TinyChipHub/bitaxeHex-TCH/Manufacturing Files/bitaxeSupraHex-702-BOM-JLC-res.xlsx

Designator | Footprint | Comment
R18,R17,R49,R71,R26,R28,R75,R48,R62,R61,R52,R58,R43,R36,R74,R6,R57,R70,R35,R53,R44,R27 | R_0402_1005Metric | 10k
J1,J2 | 63862-1 | Conn_01x01
J8,J9 | 470531000 | Conn_01x04
C23 | C_0805_2012Metric | 100nF
R25,R24 | R_0402_1005Metric | 5.6k
SW2,SW1 | TL3340-switch | SWITCH-SPST
L2 | L_Coilcraft_XAL1010-XXX | 680nH
C13 | C_0402_1005Metric | 100nF
C5 | C_0603_1608Metric | 1uF
C10,C30 | CP_Elec_6.3x5.9 | 180uF
J6 | PinHeader_1x06_P2.54mm_Vertical | Conn_01x06
U12,U28,U25,U27 | BM1368 | BM1368_mode1
R8 | R_0402_1005Metric | 12.7K
C40,C38,C44,C39,C35,C43,C34 | C_0402_1005Metric | 311-3342-1-ND
C27,C28,C29 | C_1210_3225Metric | 47uF
C2 | C_0402_1005Metric | 4.7nF
U9 | MSOP-10_3x3mm_P0.5mm | EMC2302
R9,R16 | R_0402_1005Metric | 1.37K
R13 | R_0402_1005Metric | 10R
U3 | LQFN40-CLIP | TPS546D24ARVFR
C16,C155,C152,C156,C26,C157,C154,C153 | C_0402_1005Metric | 2.2nF
U7,U8 | SOT5X3-6_DRL_TEX | TMP1075
C22 | C_0805_2012Metric | 1nF
U18,U13 | BM1368 | BM1368_mode0
J5 | PinHeader_1x04_P2.54mm_Vertical | Conn_01x04
U6 | ESP32-S3-WROOM-1U | ESP32-S3-WROOM-1
C9,C8,C4,C7 | C_1210_3225Metric | 22uF
C32,C57,C113,C107,C129,C94,C72,C131,C70,C87,C92,C52,C59,C114,C144,C91,C150,C67,C76,C108,C88,C126,C66,C112,C19,C69,C97,C149,C124,C118,C138,C100,C63,C125,C133,C143,C116,C81,C83,C137,C96,C45,C109,C99,C145,C64,C55,C117,C48,C78,C102,C90,C110,C61,C146,C77,C127,C47,C54,C79,C135,C85,C58,C141,C105,C148,C25,C134,C56,C103,C46,C115,C104,C75,C53,C74,C89,C98,C123,C11,C139,C71,C128,C119,C80,C120,C49,C65,C86,C21,C136 | C_0402_1005Metric | 1uF
J7 | USB_C_Receptacle_GCT_USB4105-xx-A_16P_TopMnt_Horizontal | USB_C_Receptacle_USB2.0
R14 | R_1206_3216Metric | 1R
C24 | C_0402_1005Metric | 100pF
C14,C15 | C_0805_2012Metric | 1uF
C12,C50,C132,C147,C111,C84,C60,C142,C130,C106,C51,C122,C121,C62,C33,C93,C95,C151,C82,C73 | C_0402_1005Metric | 0.1uF
R20,R12 | R_0402_1005Metric | 22.1k
C18,C3,C20,C31,C1 | C_0805_2012Metric | 10uF
R47,R37,R73,R69,R54,R81,R59,R34,R51,R79,R78,R55,R72,R56,R83,R82,R80,R76,R77,R50,R42,R60,R67,R45 | R_0402_1005Metric | 1k
C140,C68,C101 | CP_EIA-7343-31_Kemet-D_Pad2.25x2.55mm_HandSolder | 330uF
U23,U11,U16,U24,U10,U17 | TSOT-23-5 | AP7331
R39,R11,R31,R41,R63,R29,R65 | R_0402_1005Metric | 115k
R64,R38,R30 | R_0402_1005Metric | 115k
U4 | SOT-23-5_HandSoldering | MIC5504-1.8YM5-TR
R4,R5 | R_0402_1005Metric | 17.8K
R68,R33,R46 | R_0402_1005Metric | 2k
U5 | TSSOP-16_4.4x5mm_P0.65mm | SN74AVC4T774
R15 | R_0402_1005Metric | 49.9R
R19 | R_0402_1005Metric | 7.87k
U20 | TSSOP-20 | MAX6689UP9A+
R66,R32,R40 | R_0402_1005Metric | 402k
R87,R86,R85,R84 | R_0402_1005Metric | 4.7k
U21,U15 | TSSOP-14_4.4x5mm_P0.65mm | TLV3544
U2 | RT9080-33GJ5 | RT9080-33GJ5
R3,R2,R1 | R_0402_1005Metric | 0R
R23,R22 | R_0402_1005Metric | 5.1k
C41,C42 | CP_Elec_6.3x7.7 | 220uF
C17 | C_0402_1005Metric | 4.7uF
U1 | SOT-23-6 | LMR54410
R7 | R_0402_1005Metric | 31.6K
U14,U19,U26 | O 25,0-JO32-B-1V3-1-T1-LF | 25MHz
R21 | R_0402_1005Metric | 20k
R10 | R_0402_1005Metric | 26.1K
L1 | 74438357082 | 8.2 uH
C6 | C_0603_1608Metric | 0.1uF
D1 | DFN1610-2L | 824045812
R88,R89,R90,R91,R92,R93,R94,R95,R96,R97,R98,R99 | R_0201 | C106229
