TinyChipHub/bitaxeHex-TCH/3d/Download_STP_WE-TVS-DFN1610-2L_rev1.stp

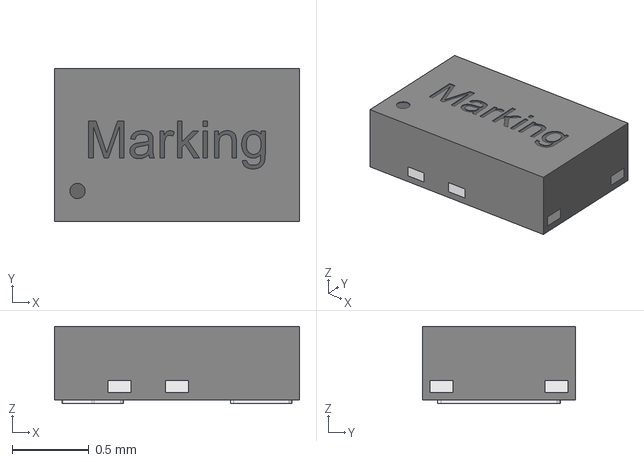
[picture p1: CAD file, 2024-09-07]
3d/Download_STP_WE-TVS-DFN1610-2L_rev1.stp
1.60 x 1.00 x 0.505 mm
pins x 7
housing
