TinyChipHub/bitaxeHex-TCH/3d/21-0066J_20_MXM.step

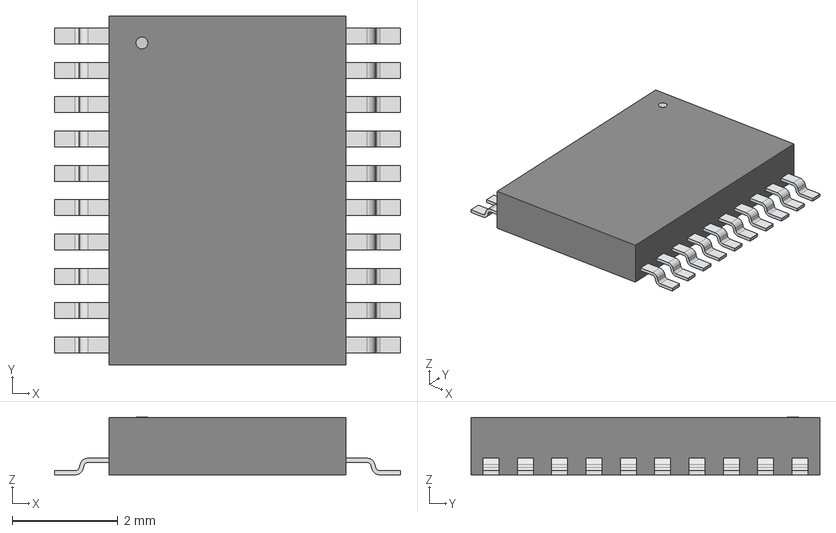
[picture p2: CAD file, 2024-08-14]
3d/21-0066J_20_MXM.step
6.55 x 6.60 x 1.09 mm
