TinyChipHub/bitaxeHex-TCH/3d/BM1368xx.stp

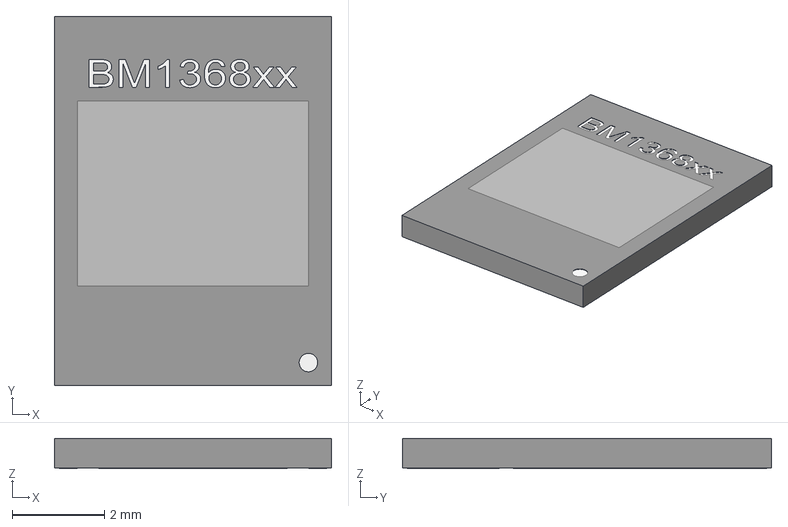
[picture p3: CAD file, 2024-08-13]
3d/BM1368xx.stp
6.00 x 8.00 x 0.65 mm
