TinyChipHub/bitaxeHex-TCH/bitaxeHex.pdf

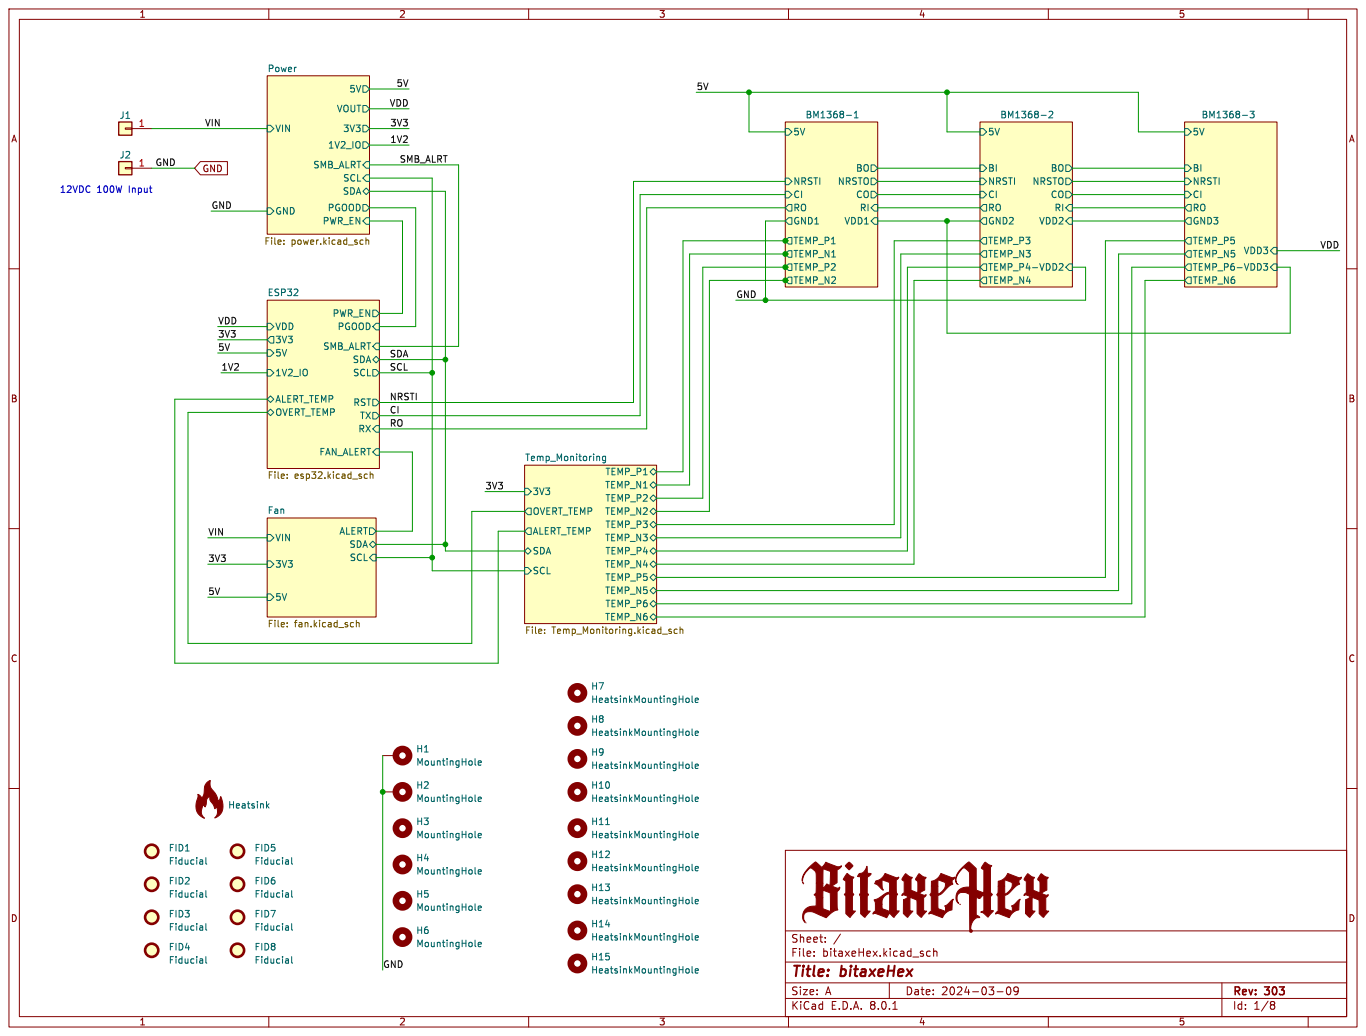
[picture p4: page 1]

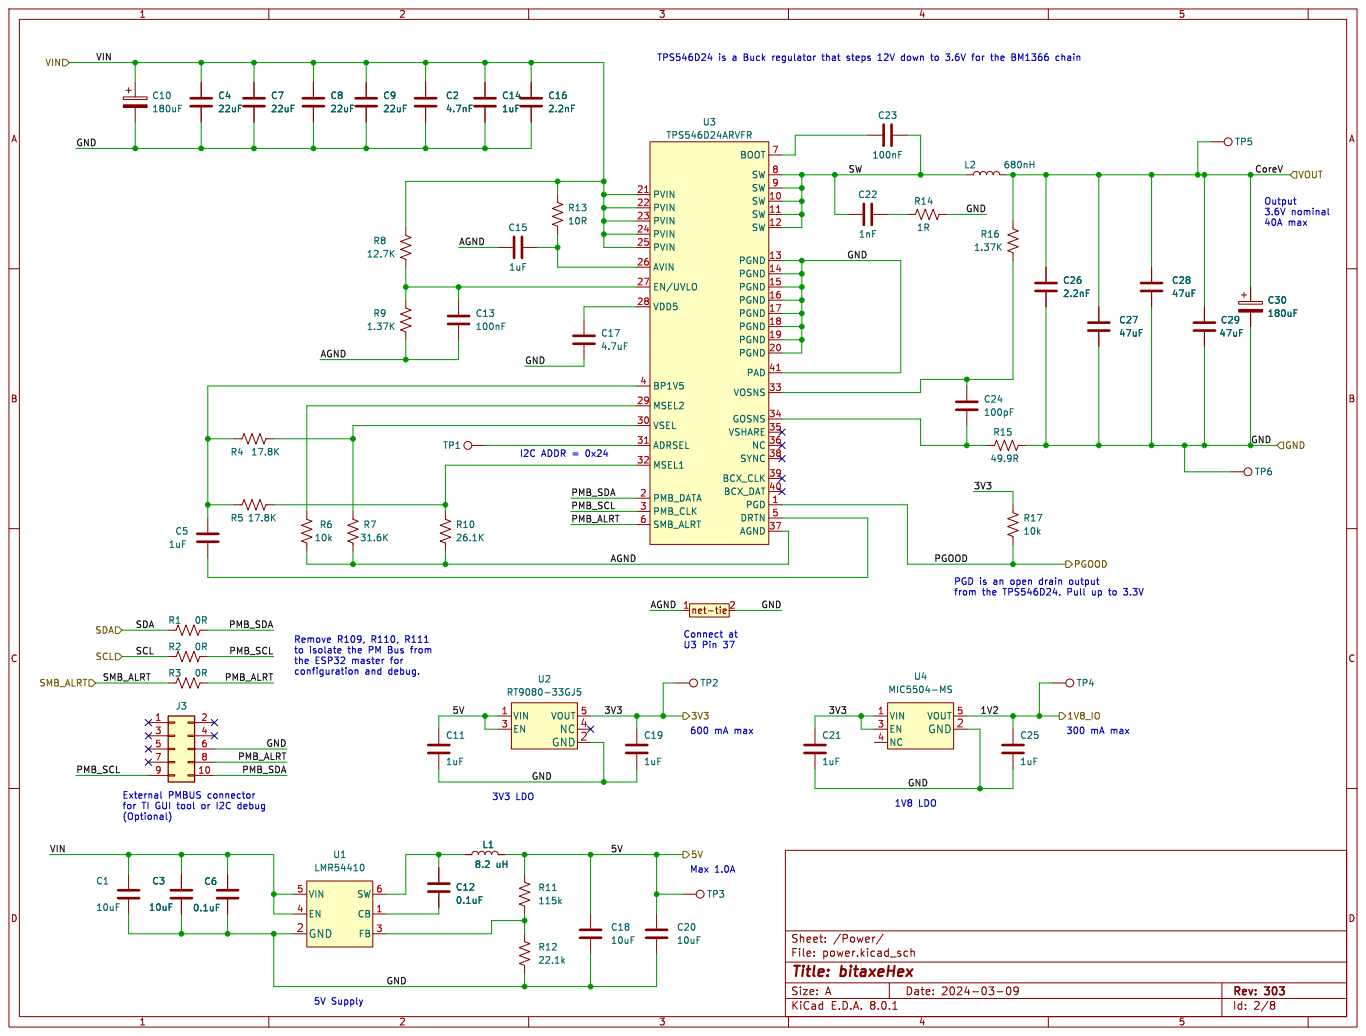
[picture p5: page 2]

File: power.kicad_sch Sheet: /Power/ C5

300 mA max PGD is an open drain output

Remove R109, R110, R111
to isolate the PM Bus from

for TI GUI tool or I2C debug
(Optional)

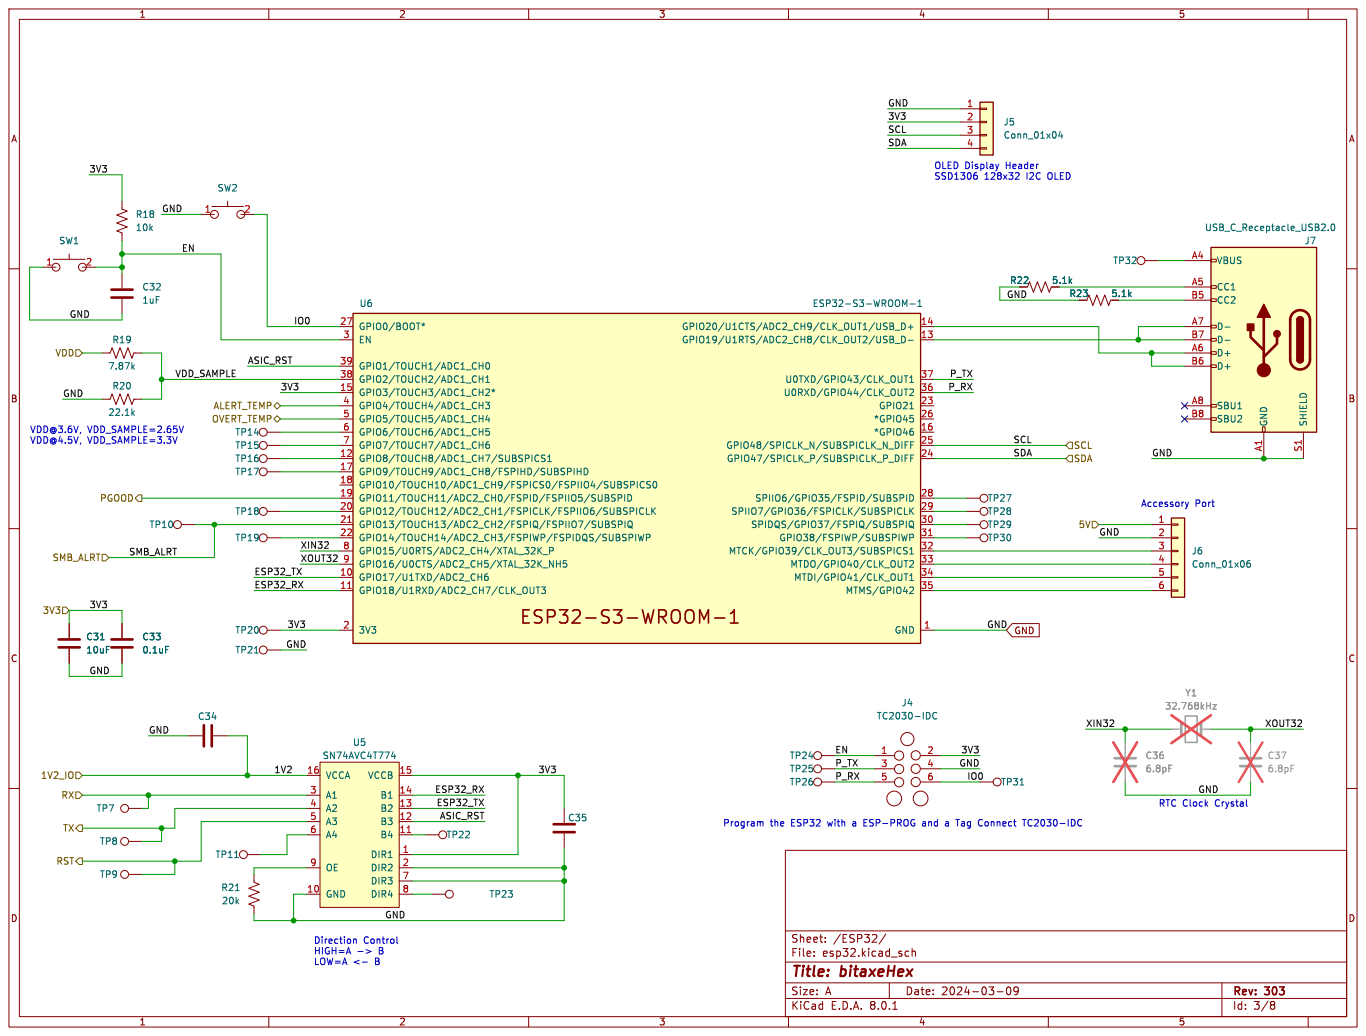
[picture p6: page 3]

Accessory Port OLED Display Header SSD1306 128x32 I2C OLED

Program the ESP32 with a ESP-PROG and a Tag Connect TC2030-IDC

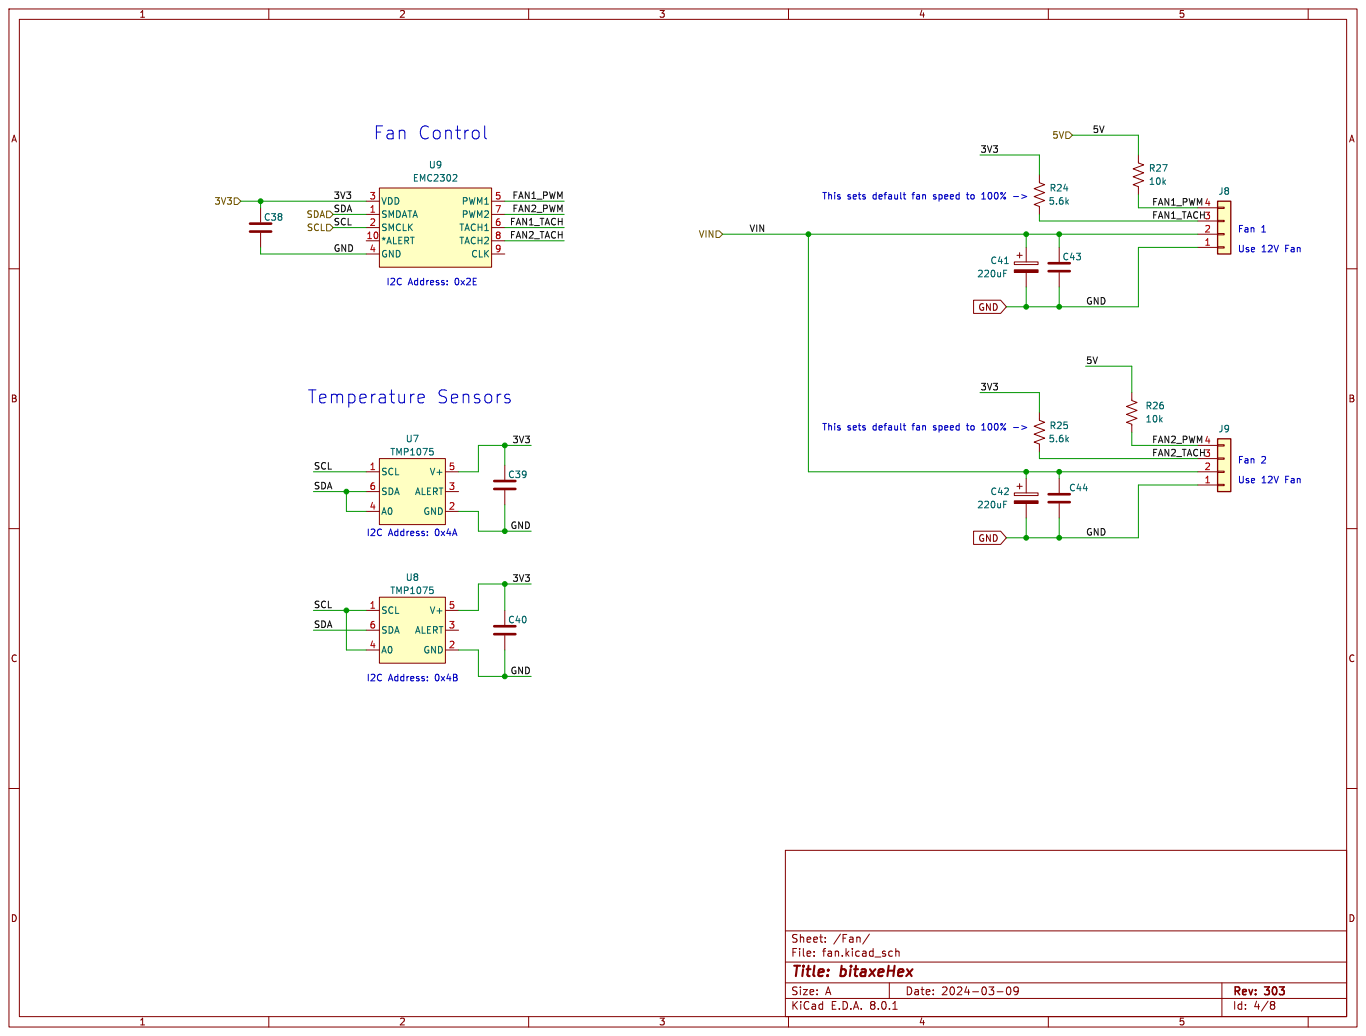
[picture p7: page 4]

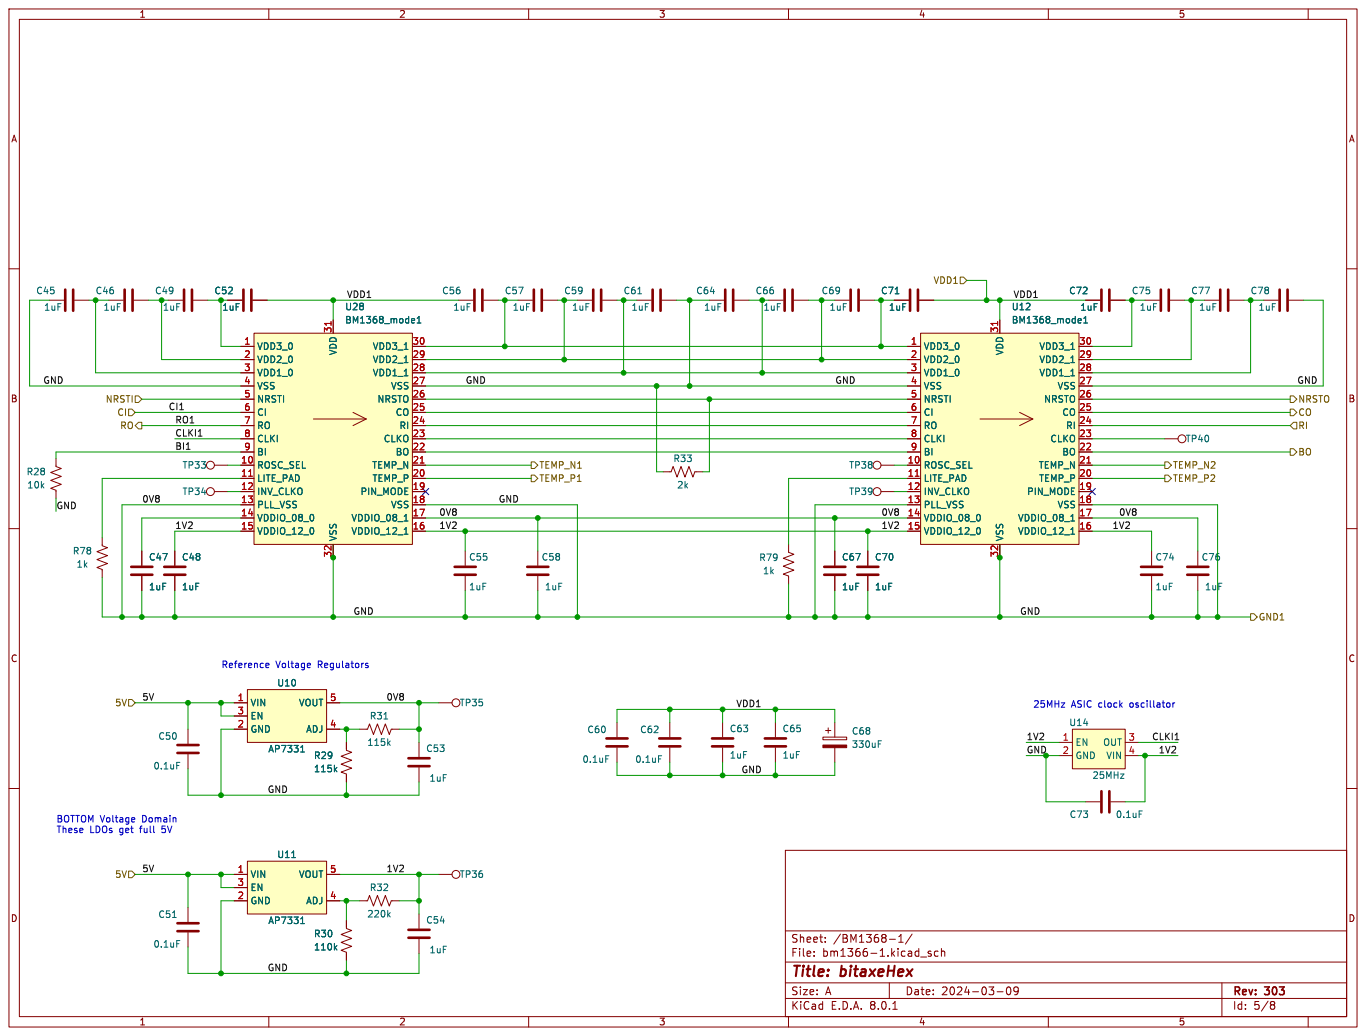
[picture p8: page 5]

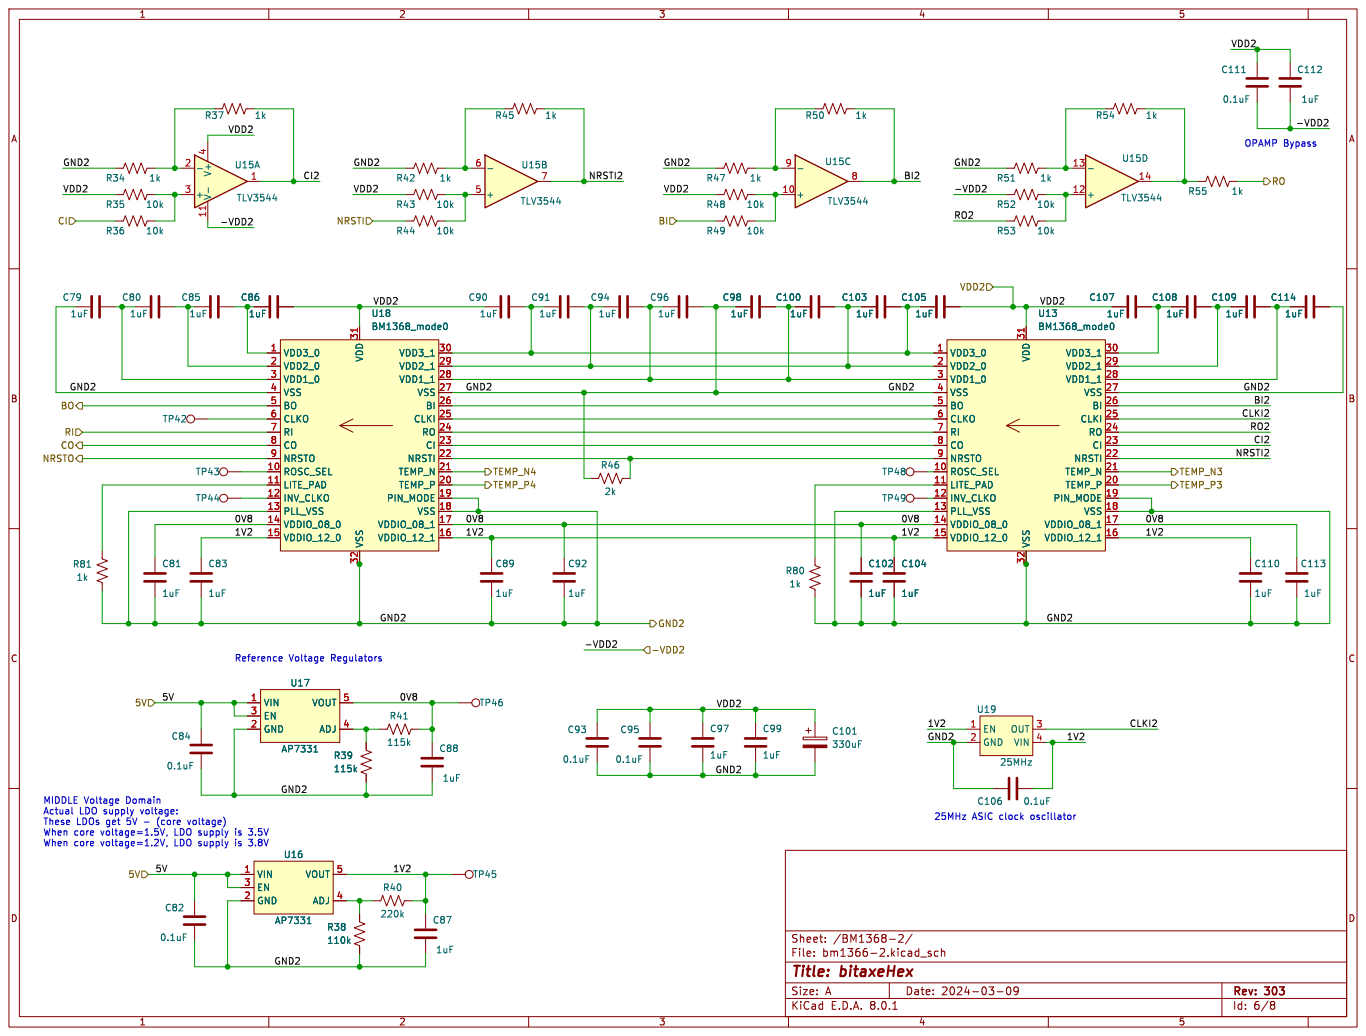
[picture p9: page 6]

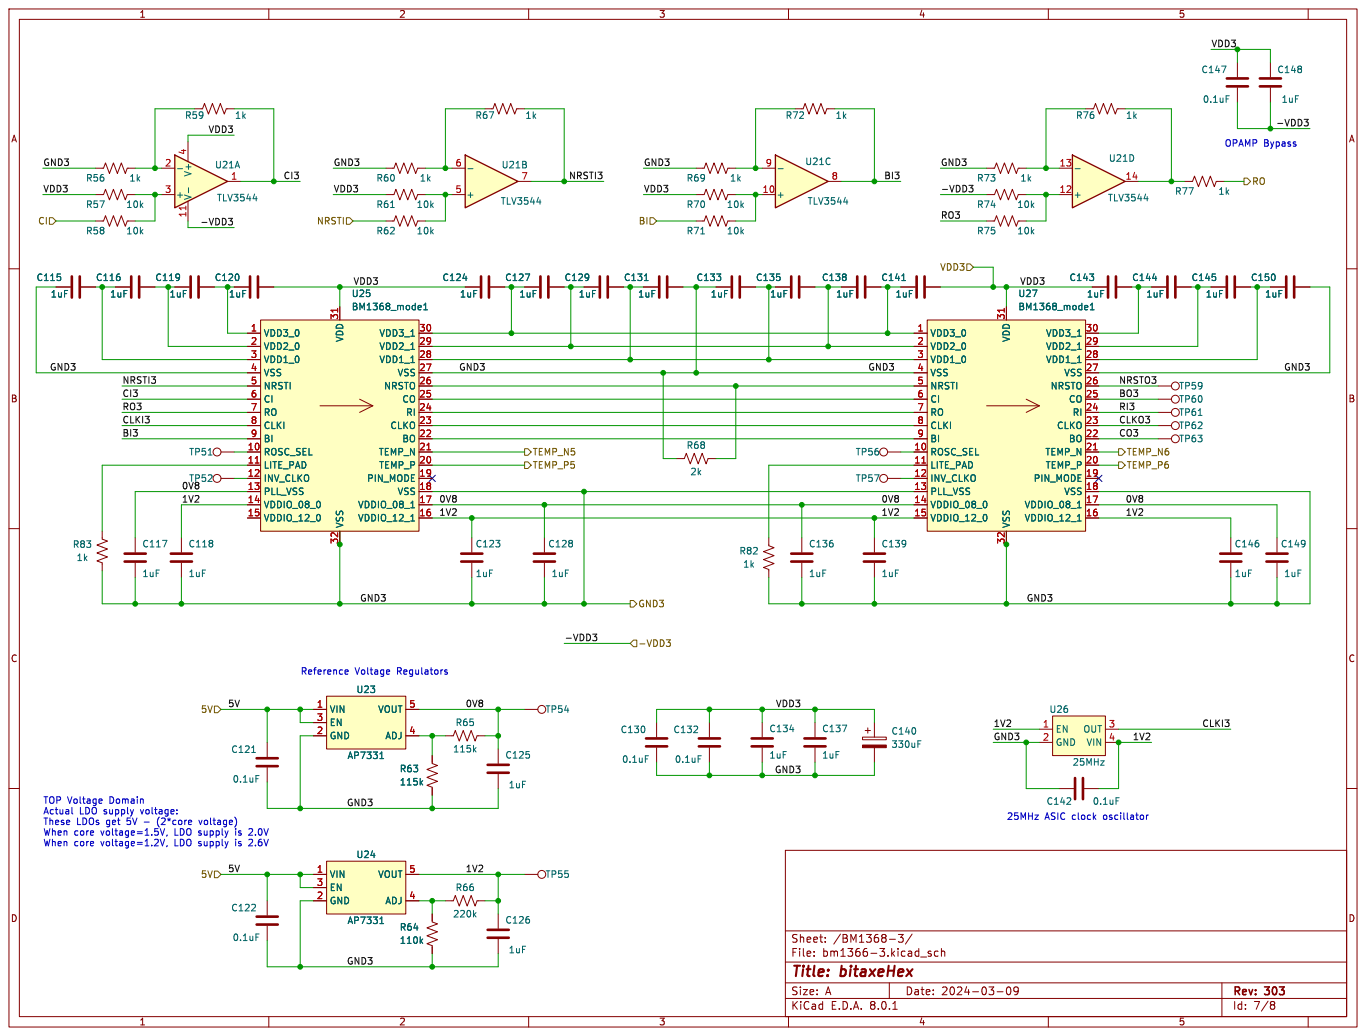
[picture p10: page 7]

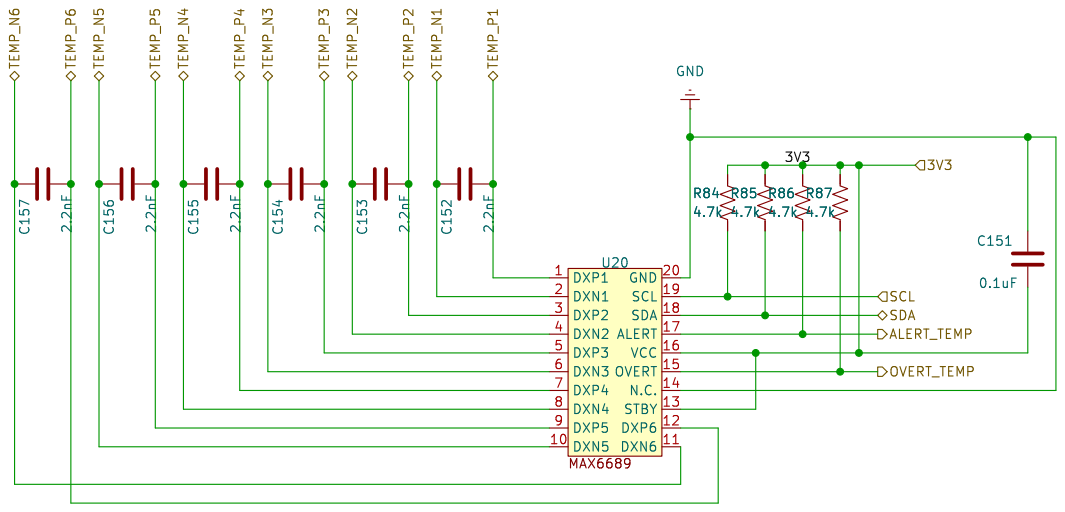
[picture p11: page 8]
