TinyChipHub/bitaxeHex-TCH/(commit log)

2024-08-10 Adding BM1368 symbol and footprint into branch
2024-08-11 Rearrange parts to fit water cooling
    [bitaxeHex.kicad_pcb]
2024-08-11 Finalized 303 production files
    [bitaxeHex-303-BOM-JLC.xlsx, bitaxeHex-303-BOM.xlsx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]
2024-08-11 Adding BM1368 footprint and symbol into project
2024-08-12 minor update
    [bitaxeHex.kicad_sch, bm1366-1.kicad_sch]
2024-08-12 finish sch rearrange for BM1368 chain
    [bm1366-1.kicad_sch, bm1366-2.kicad_sch, bm1366-3.kicad_sch, power.kicad_sch]
2024-08-12 Adding temperature monitoring
    [Temp_Monitoring.kicad_sch, bitaxeHex.kicad_sch]
2024-08-13 sch update done
    [Temp_Monitoring.kicad_sch, bitaxeHex.kicad_sch, bm1366-3.kicad_sch, esp32.kicad_sch]
2024-08-13 Finish routing
    [BM1368xx.stp, Temp_Monitoring.kicad_sch, bitaxeHex.kicad_pcb]
2024-08-14 Upload 3d model for MAX6689
    [21-0066J_20_MXM.step, bitaxeHex.kicad_pcb]
2024-08-15 mark DNP issue
    [bitaxeHex.kicad_pcb]
2024-09-05 Add Logo
    [bitaxeHex-B_Cu.gbr, bitaxeHex-B_Mask.gbr, bitaxeHex-B_Paste.gbr, bitaxeHex-B_Silkscreen.gbr, bitaxeHex-Edge_Cuts.gbr, bitaxeHex-F_Cu.gbr, bitaxeHex-F_Mask.gbr, bitaxeHex-F_Paste.gbr]
2024-09-07 Add TVS protection to avoid sudden current which may damage the TPS power regulator
    [Download_STP_WE-TVS-DFN1610-2L_rev1.stp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]
2024-09-08 Add CE logo on it
    [bitaxeHex.kicad_pcb]
2024-09-09 Reset to 1V8/0V8 setting
    [bitaxeHex-B_Cu.gbr, bitaxeHex-B_Mask.gbr, bitaxeHex-B_Paste.gbr, bitaxeHex-B_Silkscreen.gbr, bitaxeHex-Edge_Cuts.gbr, bitaxeHex-F_Cu.gbr, bitaxeHex-F_Mask.gbr, bitaxeHex-F_Paste.gbr]
2024-09-22 Add resisters for MAX6689
    [Temp_Monitoring.kicad_sch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]
2024-09-22 Reset to 1V8
    [bitaxeHex-B_Cu.gbr, bitaxeHex-B_Mask.gbr, bitaxeHex-B_Paste.gbr, bitaxeHex-B_Silkscreen.gbr, bitaxeHex-Edge_Cuts.gbr, bitaxeHex-F_Cu.gbr, bitaxeHex-F_Mask.gbr, bitaxeHex-F_Paste.gbr]
2025-03-10 upgrade board version to 703
    [bitaxeHex.kicad_pcb, power.kicad_sch]
